koksunbaev-hash/electric_meters/diagnostics/README.md

# Диагностические скетчи ESP32

Эти скетчи помогли найти неисправности, которые снаружи выглядели одинаково — «данные не идут». Каждый проверяет одно звено.

| Скетч | Что проверяет | Норма |
|---|---|---|
| [`esp32-pin-check2`](esp32-pin-check2) | Исправность ножек ESP32: вывод удерживает заданный уровень, подтяжки работают. Запускать на плате без обвязки | `itogo neispravnyh vyvodov: 0` |
| [`esp32-meter-diag`](esp32-meter-diag) | Отвечает ли счётчик DDSD6868 по Modbus | `OTVET VERNYY, U=...` |
| [`esp32-ro-level`](esp32-ro-level) | Запитан ли MAX485 и жив ли его приёмник: уровень покоя на выходе RO | RO высокий, 200 из 200 |
| [`esp32-ab-drive`](esp32-ab-drive) | Жив ли передатчик MAX485: передатчик включён постоянно, вход DI медленно переключается. Мультиметр на A–B | Знак меняется, модуль 2–5 В |
| [`esp32-dtu-listen`](esp32-dtu-listen) | Выдаёт ли модем EWD95M текст при включении питания | `NVM DATA STORED`, `+EVT:JOINED` |

Все скетчи выводят результат в монитор порта на 115200.

## Как пользоваться

Иди от сервера к проводу и останавливайся на первом звене, где данных нет (см. [инструкцию](../docs/instruction.md#если-данные-перестали-приходить)). Когда дошёл до железа:

1. Плата ESP32 не отвечает вовсе — сними обвязку и попробуй `esptool --port COMx chip-id`. Не отвечает даже с зажатой BOOT — плата мертва.
2. Плата жива — `esp32-pin-check2` на голой плате.
3. Ножки целы — `esp32-ro-level`, затем `esp32-ab-drive` с мультиметром.
4. Всегда сравнивай с заведомо рабочим модулем: одно измерение без образца легко прочитать неверно.

## Одно правило

Не настраивай на передачу ножку, к которой подключён выход RO преобразователя. Два выхода на одном проводе упираются друг в друга, и порт зависает до перезагрузки. Порядок выводов RO и DI проверяется мультиметром, а не перебором в прошивке.
