koksunbaev-hash/electric_meters/docs/reports/Отчет Однофазный счетчик LoRaWAN.docx

________________________________________________

(наименование организации)

УТВЕРЖДАЮ

_____________________ /_______________/

(должность, подпись, расшифровка)

«____» ______________ 2026 г.

ОТЧЁТ

о вводе в действие системы удалённого учёта электроэнергии

на базе однофазного счётчика CHZSJ DDSD6868 с передачей данных

по сети LoRaWAN в платформу цифровых двойников OpenEgiz

Объект учёта: испытательный стенд лаборатории lower_lab

Идентификатор цифрового двойника: lower_lab:lorawan-meter

Сетевой сервер LoRaWAN: ChirpStack, 192.168.8.122

Сервер платформы: 192.168.0.199

Период выполнения работ: с 9 по 14 сентября 2026 г.

Исполнитель: _____________________ /_______________/

(должность, подпись, расшифровка)

Редакция 1.0

2026 г.

# Аннотация

Настоящий отчёт содержит результаты работ по вводу в действие системы удалённого учёта электроэнергии на базе однофазного счётчика CHZSJ DDSD6868. Система включает прибор учёта, узел сопряжения на базе микроконтроллера ESP32 с двумя интерфейсами RS485, оконечное устройство LoRaWAN Ebyte EWD95M, базовую станцию, сетевой сервер ChirpStack и серверную часть на платформе цифровых двойников OpenEgiz, развёрнутой на узле 192.168.0.199.

Отличительной особенностью системы является передача показаний по сети LoRaWAN вместо ранее применявшегося канала Wi-Fi. Такое решение обеспечивает связь на расстояниях до нескольких километров и не требует наличия точки доступа в месте установки прибора учёта.

В отчёте описаны состав и назначение полевого оборудования, протокол обмена с прибором учёта, формат передаваемого пакета, порядок его расшифровки на сетевом сервере, состав серверных программных компонентов и маршрут данных до средств отображения. Приведены результаты проверки работоспособности системы и рекомендации по её эксплуатации и развитию.

Отчёт предназначен для руководства и заказчика проекта, а также для специалистов, осуществляющих эксплуатацию и развитие системы. Разделы 1 и 2 не требуют специальной подготовки, технические сведения вынесены в приложения.

Отчёт содержит 8 разделов и два приложения, 15 таблиц.

# СОДЕРЖАНИЕ

Аннотация ..................................................................... 2

Термины, определения и сокращения ............................................. 4

1. Введение ................................................................... 6

2. Общее описание системы ..................................................... 8

3. Полевое оборудование узла учёта ............................................ 9

4. Передача и обработка данных ................................................ 12

5. Серверная часть ............................................................ 15

6. Результаты проверки работоспособности ...................................... 18

7. Рекомендации по эксплуатации и развитию .................................... 20

8. Заключение ................................................................. 21

Приложение А. Справочные параметры системы .................................... 22

Приложение Б. Состав разработанного программного обеспечения .................. 23

# Термины, определения и сокращения

В настоящем отчёте применяются следующие термины и сокращения.

Таблица 1. Термины и сокращения

Термин | Определение
LoRaWAN | Протокол беспроводной связи для устройств телеметрии, работающий в нелицензируемых частотных диапазонах. Обеспечивает дальность до нескольких километров при малом энергопотреблении.
EU868 | Частотный план LoRaWAN для диапазона 863–870 МГц. Предусматривает ограничение занятости эфира одним процентом времени.
OTAA | Способ подключения устройства к сети LoRaWAN по ключам шифрования с получением сеансовых параметров от сетевого сервера.
DevEUI | Уникальный заводской идентификатор оконечного устройства LoRaWAN, 8 байт.
AppKey | Ключ приложения, применяемый при подключении устройства к сети способом OTAA, 16 байт.
Класс A | Режим работы оконечного устройства, при котором приём возможен только в двух окнах после собственной передачи. Обеспечивает наименьшее энергопотребление.
Базовая станция | Приёмопередающее устройство сети LoRaWAN, принимающее пакеты от оконечных устройств и передающее их сетевому серверу.
ChirpStack | Сетевой сервер LoRaWAN с открытым исходным кодом. Выполняет подключение устройств, проверку целостности пакетов и их выдачу прикладным системам.
Декодер пакета | Программа на языке JavaScript, исполняемая сетевым сервером и преобразующая двоичный пакет в именованные величины.
RS485 | Промышленный последовательный интерфейс передачи данных по двухпроводной линии (цепи A и B). Применяется для подключения приборов учёта.
Modbus RTU | Протокол обмена данными по последовательной линии, применяемый в приборах учёта. Обмен ведётся кадрами с контрольной суммой CRC16.
UART | Последовательный порт микроконтроллера. Преобразователь RS485/UART согласует уровни сигналов прибора учёта и контроллера.
DE/RE | Вывод управления направлением передачи преобразователя RS485. Высокий уровень переводит преобразователь в режим передачи, низкий — в режим приёма.
ESP32 | Микроконтроллер с двумя вычислительными ядрами и встроенными модулями Wi-Fi и Bluetooth, применяемый в узле сопряжения.
MQTT | Протокол обмена сообщениями для устройств телеметрии по модели «издатель, брокер, подписчик».
Брокер MQTT | Серверная программа, принимающая сообщения от издателей и передающая их подписчикам. В системе применяется Mosquitto.
Мост данных | Служебная программа, переносящая сообщения между двумя брокерами MQTT с преобразованием формата.
JSON | Текстовый формат представления структурированных данных.
Цифровой двойник | Программное представление физического объекта, хранящее его текущее состояние.
Eclipse Ditto | Программная платформа управления цифровыми двойниками, ядро OpenEgiz.
OpenEgiz | Платформа цифровых двойников на базе OpenTwins, развёрнутая на сервере системы.
InfluxDB | База данных временных рядов для хранения измерений с метками времени.
Grafana | Средство визуализации данных и построения информационных панелей.
systemd | Подсистема управления службами Linux, обеспечивающая автоматический запуск и перезапуск программ.

# 1. Введение

## 1.1. Цель работ

Целью работ является ввод в действие системы удалённого учёта электроэнергии на базе однофазного счётчика CHZSJ DDSD6868 с передачей показаний по сети LoRaWAN, включая настройку полевого оборудования, разработку программного обеспечения узла сопряжения, организацию маршрута данных до платформы цифровых двойников и средств визуализации.

## 1.2. Объект работ

Объектом работ является измерительный комплекс, состоящий из однофазного электросчётчика, узла сопряжения на базе микроконтроллера ESP32, оконечного устройства LoRaWAN и серверной части. Комплекс обеспечивает автоматическое считывание показаний прибора учёта, их передачу по радиоканалу и последующее хранение, обработку и визуализацию.

## 1.3. Исходные данные

Работы выполнены на основании следующих исходных данных:

- однофазный электросчётчик CHZSJ DDSD6868, заводской номер 2511262172, с интерфейсом RS485;
- оконечное устройство LoRaWAN Ebyte EWD95M с интерфейсом RS485, заводской идентификатор 0080E115053FE291;
- микроконтроллер ESP32-D0WD-V3, адрес 1c:c3:ab:b4:94:30, и два преобразователя RS485/UART на микросхеме MAX485;
- действующая базовая станция LoRaWAN с идентификатором 0016c001f17a6c24 и сетевой сервер ChirpStack на узле 192.168.8.122;
- действующая платформа OpenEgiz на узле 192.168.0.199 с ранее настроенным контуром приёма сообщений;
- руководство по эксплуатации серии EWD95M (редакция 1.2) и техническая документация прибора учёта.

## 1.4. Методика выполнения работ

Работы выполнялись в следующем порядке.

1. Определение протокола обмена и карты регистров прибора учёта опытным путём с последующей сверкой полученных значений с показаниями встроенного дисплея.
2. Сборка полевого узла: подключение прибора учёта и оконечного устройства LoRaWAN к микроконтроллеру через раздельные преобразователи RS485.
3. Разработка и отладка программы микроконтроллера, обеспечивающей опрос прибора учёта, формирование пакета и управление оконечным устройством командами AT.
4. Регистрация оконечного устройства на сетевом сервере, проверка подключения к сети и прохождения пакетов.
5. Разработка декодера пакета для сетевого сервера и его проверка на фактически принятых пакетах.
6. Разработка моста данных между сетевым сервером и платформой цифровых двойников, его установка на сервер в виде службы с автоматическим запуском.
7. Создание информационной панели в средстве визуализации и сквозная проверка маршрута данных от прибора учёта до графика.

# 2. Общее описание системы

Система обеспечивает автоматическое считывание показаний однофазного электросчётчика с периодом 30 секунд и передачу их на сервер платформы OpenEgiz по радиоканалу LoRaWAN. Применение LoRaWAN отличает настоящую систему от ранее введённых узлов учёта, использующих Wi-Fi, и позволяет размещать прибор учёта вне зоны действия точки доступа.

Маршрут данных состоит из двух участков. На первом участке микроконтроллер опрашивает прибор учёта по проводной линии RS485 и передаёт результат оконечному устройству LoRaWAN, также по линии RS485. На втором участке оконечное устройство передаёт пакет по радиоканалу базовой станции, которая направляет его сетевому серверу ChirpStack. Сетевой сервер расшифровывает пакет и публикует результат в своём брокере сообщений.

Мост данных, работающий на сервере платформы, переносит расшифрованные показания в брокер OpenEgiz. Далее данные обрабатываются двумя независимыми контурами, ранее созданными для других узлов учёта.

- Контур архива измерений. Каждое измерение сохраняется в базе данных временных рядов с меткой времени и обеспечивает ретроспективный анализ за произвольный период.
- Контур цифрового двойника. Последние значения измеряемых величин записываются в цифровой двойник объекта и обеспечивают оперативный контроль текущего состояния.

Таблица 2. Основные характеристики системы

Показатель | Значение
Объект учёта | Испытательный стенд лаборатории lower_lab
Прибор учёта | Однофазный электросчётчик CHZSJ DDSD6868, заводской номер 2511262172
Измеряемые величины | 5 параметров: напряжение, ток, активная мощность, коэффициент мощности, активная энергия
Протокол обмена с прибором учёта | Modbus RTU, 9600 бит/с, 8 бит данных, чётность even, 1 стоповый бит
Период опроса | 30 секунд (2 880 измерений в сутки)
Канал передачи | LoRaWAN, частотный план EU868, класс устройства A
Размер передаваемого пакета | 12 байт, прикладной порт 2
Сетевой сервер LoRaWAN | ChirpStack, 192.168.8.122
Платформа цифровых двойников | OpenEgiz, 192.168.0.199
Идентификатор цифрового двойника | lower_lab:lorawan-meter
Начало накопления данных | 09.09.2026
Уровень принимаемого сигнала | от минус 99 до минус 110 дБм, отношение сигнал/шум от 5 до 10 дБ

# 3. Полевое оборудование узла учёта

## 3.1. Состав оборудования

Состав полевого оборудования приведён в таблице 3. Узел сопряжения содержит два независимых преобразователя RS485: первый обслуживает линию связи с прибором учёта, второй — линию связи с оконечным устройством LoRaWAN. Раздельные линии применены в связи с различием форматов кадра: прибор учёта работает с контролем чётности, оконечное устройство — без него.

Таблица 3. Состав полевого оборудования

Оборудование | Назначение | Характеристики
Электросчётчик CHZSJ DDSD6868 | Измерение параметров однофазной сети и учёт активной энергии | 220 В, 5(60) А, 50 Гц, 1600 имп/кВт·ч, стандарт GB/T 17215.321-2021, интерфейс RS485 (клеммы 6 и 5), импульсный выход (клеммы 1 и 2), заводской номер 2511262172
Преобразователь RS485/UART № 1 | Согласование интерфейса прибора учёта с портом контроллера | Плата на микросхеме MAX485, управление направлением передачи выводом DE/RE
Преобразователь RS485/UART № 2 | Согласование интерфейса оконечного устройства с портом контроллера | Плата на микросхеме MAX485, управление направлением передачи выводом DE/RE
Микроконтроллер ESP32 | Опрос прибора учёта, формирование пакета, управление оконечным устройством | ESP32-D0WD-V3, ревизия 3.1, два ядра, 240 МГц, флеш-память 4 МБ, адрес 1c:c3:ab:b4:94:30
Оконечное устройство LoRaWAN Ebyte EWD95M | Передача пакета по радиоканалу | Диапазон 863–870 МГц, класс A, интерфейс RS485 9600 бит/с 8N1, питание от 5 до 28 В постоянного тока, монтаж на DIN-рейку
Базовая станция LoRaWAN | Приём пакетов и передача их сетевому серверу | Идентификатор 0016c001f17a6c24, частотный план EU868
Блок питания 220/5 В | Питание контроллера и преобразователей | Импульсный, выходное напряжение 5 В

## 3.2. Измеряемые величины

Из прибора учёта считываются пять величин. Соответствие адресов регистров, масштабных множителей и имён признаков цифрового двойника приведено в таблице 4. Карта регистров определена опытным путём с последующей сверкой полученных значений с показаниями встроенного дисплея прибора учёта.

Таблица 4. Измеряемые величины и карта регистров

Величина | Регистр | Формат | Множитель | Признак двойника
Напряжение, В | 0x0000 | uint16 | 0,1 | voltage_a_v
Ток, А | 0x0003 | uint16 | 0,01 | current_a_a
Активная мощность, Вт | 0x0008 | uint16 | 1 | active_power_w
Коэффициент мощности | 0x0013 | uint16 | 0,001 | power_factor_total
Активная энергия, кВт·ч | 0x001D–0x001E | uint32 | 0,01 | active_energy_positive_kwh

Частота сети (регистр 0x001A, множитель 0,01) считывается и выводится в служебный журнал контроллера, но в передаваемый пакет не включена в целях сокращения его размера.

## 3.3. Порядок работы контроллера

Программа контроллера esp32-meter-lorawan-v7 выполняет следующие действия.

8. Инициализация портов: порт прибора учёта настраивается на 9600 бит/с с контролем чётности, порт оконечного устройства — на 9600 бит/с без контроля чётности.
9. Поиск оконечного устройства LoRaWAN. Программа последовательно опрашивает четыре предусмотренных набора выводов командой AT и закрепляет за собой тот, на котором получен ответ. Решение позволяет изменять монтаж без перепрошивки контроллера.
10. Считывание заводского идентификатора и частотного плана оконечного устройства. Частотный план принимается таким, как он задан в устройстве, и программой не изменяется.
11. Подключение к сети LoRaWAN способом OTAA командой AT+CJOIN. Устройство настроено на автоматическое подключение при включении питания.
12. Опрос прибора учёта: передача кадра Modbus, приём ответа, проверка контрольной суммы CRC16, масштабирование значений. При отсутствии ответа выполняется до трёх повторных попыток.
13. Формирование пакета размером 12 байт и передача его оконечному устройству командой AT+SEND с указанием прикладного порта 2.
14. Ожидание следующего цикла. Период передачи составляет 30 секунд.

Управление направлением передачи преобразователей RS485 выполняется программно выводом DE/RE. Линия удерживается в режиме передачи на время отправки кадра и освобождается непосредственно после его окончания, что необходимо для приёма ответа.

Таблица 5. Назначение выводов микроконтроллера

Линия | Приём (RO) | Передача (DI) | Управление (DE/RE) | Формат кадра
Прибор учёта | GPIO 26 | GPIO 27 | GPIO 5 | 9600, 8E1
Оконечное устройство LoRaWAN | GPIO 19 | GPIO 18 | GPIO 23 | 9600, 8N1

Примечание. Программа контроллера предусматривает передачу пакета только после успешного считывания показаний. Нарушение линии RS485 или питания прибора учёта приводит к прекращению передачи при сохранении работоспособности радиоканала.

# 4. Передача и обработка данных

## 4.1. Маршрут данных

Маршрут данных от прибора учёта до средств отображения приведён в таблице 6. Маршрут включает семь участков и два сервера.

Таблица 6. Маршрут передачи и обработки данных

№ | Участок | Среда передачи | Формат данных
1 | Прибор учёта — узел сопряжения | RS485, двухпроводная линия | Кадр Modbus RTU
2 | Узел сопряжения — оконечное устройство | RS485, двухпроводная линия | Команда AT+SEND с пакетом в шестнадцатеричном виде
3 | Оконечное устройство — базовая станция | Радиоканал LoRaWAN, EU868 | Пакет 12 байт, прикладной порт 2
4 | Базовая станция — сетевой сервер | Локальная сеть | Протокол базовой станции
5 | Сетевой сервер — мост данных | Брокер MQTT сервера ChirpStack | Сообщение JSON с полем object
6 | Мост данных — платформа OpenEgiz | Брокер MQTT 192.168.0.199:30511 | Сообщение JSON с полями device_id и data
7 | Платформа — средства отображения | Внутренние подписки платформы | Признаки цифрового двойника и записи архива

## 4.2. Формат передаваемого пакета

Пакет имеет постоянный размер 12 байт. Такой размер выбран из условия сокращения занятости эфира: при частотном плане EU868 действует ограничение на долю времени передачи, равное одному проценту. Структура пакета приведена в таблице 7.

Таблица 7. Структура передаваемого пакета

Байты | Содержание | Формат | Множитель
0 | Версия формата, значение 0x01 | uint8 | —
1–2 | Напряжение, В | uint16, старший байт первым | 0,1
3–4 | Ток, А | uint16, старший байт первым | 0,01
5–6 | Активная мощность, Вт | uint16, старший байт первым | 1
7 | Коэффициент мощности | uint8 | 0,01
8–11 | Активная энергия, кВт·ч | uint32, старший байт первым | 0,01

Пример фактически принятого пакета и результат его расшифровки:

01 08 75 00 00 00 00 64 00 00 00 36

напряжение 216,5 В

ток 0,00 А

активная мощность 0 Вт

коэффициент мощности 1,00

активная энергия 0,54 кВт·ч

## 4.3. Расшифровка пакета на сетевом сервере

Расшифровка выполняется программой на языке JavaScript, размещённой в профиле устройства EWD95M на сетевом сервере ChirpStack. Программа проверяет размер пакета и версию формата, после чего выделяет пять величин и возвращает их именованными полями. При несоответствии размера или версии возвращается сообщение об ошибке, что исключает запись недостоверных значений.

Имена возвращаемых полей выбраны совпадающими с именами признаков цифрового двойника, что позволяет переносить значения без дополнительного преобразования.

## 4.4. Мост данных

Сетевой сервер ChirpStack и платформа OpenEgiz размещены в различных подсетях и непосредственного обмена не ведут. Перенос сообщений выполняет мост данных — программа chirpstack_to_opentwins.py, установленная на сервере платформы.

Мост подписан на группу топиков сетевого сервера, соответствующую пакетам от оконечных устройств, и выполняет следующие действия: определяет заводской идентификатор устройства, сопоставляет его с идентификатором цифрового двойника по таблице соответствия, извлекает расшифрованные величины и публикует их в брокер платформы.

Предусмотрено резервное поведение: если расшифрованные величины в сообщении отсутствуют, мост самостоятельно разбирает двоичный пакет по тем же правилам, что и декодер сетевого сервера. Это обеспечивает работоспособность системы при изменении настроек сетевого сервера.

Мост восстанавливает соединение с любым из двух брокеров при его потере и ведёт журнал работы средствами операционной системы.

## 4.5. Формат сообщения платформы

Сообщение, публикуемое мостом, представляет собой текст в формате JSON. Поле device_id содержит идентификатор цифрового двойника, объект data содержит измеренные величины.

{ "device_id": "lower_lab:lorawan-meter",

"data": { "voltage_a_v": 216.6,

"current_a_a": 0.0,

"active_power_w": 0,

"power_factor_total": 1.0,

"active_energy_positive_kwh": 0.54 } }

Сообщение публикуется в топик opentwins/lower_lab:lorawan-meter. Серверные компоненты платформы подписаны на группу топиков opentwins/#, что позволило подключить новый прибор учёта без изменения их конфигурации.

# 5. Серверная часть

## 5.1. Сетевой сервер LoRaWAN

Сетевой сервер ChirpStack размещён на узле 192.168.8.122. Параметры регистрации оконечного устройства приведены в таблице 8.

Таблица 8. Параметры устройства на сетевом сервере

Параметр | Значение
Веб-интерфейс | http://192.168.8.122:8080
Брокер сообщений | 192.168.8.122:1883
Базовая станция | 0016c001f17a6c24, состояние: на связи
Профиль устройства | EWD95M, частотный план EU868, класс A, способ подключения OTAA
Заводской идентификатор (DevEUI) | 0080E115053FE291
Идентификатор приложения (JoinEUI) | 0000000000000000
Адрес в сети (DevAddr) | назначается сетевым сервером при подключении
Прикладной порт | 2
Декодер пакета | JavaScript, размещён в профиле устройства

## 5.2. Платформа цифровых двойников

Платформа OpenEgiz размещена на узле 192.168.0.199 в кластере Kubernetes. Компоненты, задействованные в настоящей системе, приведены в таблице 9. Состав компонентов платформы при выполнении работ не изменялся.

Таблица 9. Задействованные программные компоненты платформы

Компонент | Назначение | Порт
Mosquitto | Брокер MQTT, приём сообщений от моста данных | 30511
Eclipse Ditto | Управление цифровыми двойниками, преобразование сообщений | 30525
InfluxDB 2 | База данных временных рядов, архив измерений | 30716
Grafana | Визуализация данных, информационные панели | 30718
MongoDB | Хранение состояния цифровых двойников | 30717
opentwins-bridge | Мост данных, служба systemd, установлена в ходе настоящих работ | —

## 5.3. Цифровой двойник объекта учёта

Для объекта учёта зарегистрирован цифровой двойник со следующими параметрами.

Таблица 10. Параметры цифрового двойника

Параметр | Значение
Идентификатор | lower_lab:lorawan-meter
Наименование | LoRaWAN meter DDSD6868
Описание | EWD95M → ChirpStack → OpenEgiz
Политика доступа | lower_lab:lorawan-meter
Число признаков | 5
Источник данных | Электросчётчик CHZSJ DDSD6868 через сеть LoRaWAN

## 5.4. Служба моста данных

Мост данных установлен на сервере платформы в виде службы systemd с именем opentwins-bridge. Служба запускается автоматически при загрузке операционной системы и перезапускается при любом аварийном завершении с задержкой 10 секунд. Журнал работы ведётся средствами journald.

Размещение моста на сервере платформы исключает зависимость системы от персонального компьютера оператора и обеспечивает круглосуточную передачу данных.

## 5.5. Информационная панель

В средстве визуализации создана информационная панель с идентификатором ddsd6868-lorawan. Панель содержит пять полей текущих значений и четыре графика: напряжение, активная мощность, ток и накопленная энергия. Период обновления составляет 30 секунд, отображаемый интервал по умолчанию — 6 часов. Адрес панели: http://192.168.0.199:30718/d/ddsd6868-lorawan

# 6. Результаты проверки работоспособности

## 6.1. Сквозная проверка маршрута

Выполнена сквозная проверка маршрута данных на всех семи участках. Результаты приведены в таблице 11.

Таблица 11. Результаты проверки участков маршрута

Участок | Способ проверки | Результат
Прибор учёта — узел сопряжения | Служебный журнал контроллера, сверка с дисплеем прибора учёта | Показания считываются, значения совпадают
Узел сопряжения — оконечное устройство | Ответ устройства на команды AT в служебном журнале | Устройство отвечает на команды
Оконечное устройство — сеть LoRaWAN | Событие подключения на сетевом сервере | Подключение выполнено, адрес в сети назначен
Радиоканал | Уровень сигнала и отношение сигнал/шум принятых пакетов | От минус 99 до минус 110 дБм, от 5 до 10 дБ
Сетевой сервер — расшифровка | Сравнение расшифрованных величин с показаниями контроллера | Значения совпадают
Мост данных | Журнал службы, состояние цифрового двойника | Сообщения переносятся, двойник обновляется
Архив и визуализация | Запрос к базе данных временных рядов | Записи поступают, метки времени соответствуют моменту передачи

## 6.2. Накопленные данные

Первые записи в архиве измерений датированы 9 сентября 2026 г. Сведения о накопленных данных приведены в таблице 12.

Таблица 12. Сведения о накопленных данных

Показатель | Значение
Первая запись | 09.09.2026
Последняя запись на дату отчёта | 14.09.2026
Измерение в базе данных | esp_telemetry, тег thingId
Диапазон напряжения | от 215,4 до 219,3 В
Показание активной энергии | изменилось с 0,23 до 0,54 кВт·ч
Наибольшая зафиксированная мощность | 100 Вт (испытательная нагрузка)
Период передачи | 30 секунд

## 6.3. Оценка работоспособности

Измерительная цепь, радиоканал и серверная часть функционируют в соответствии с заложенным алгоритмом. Значения физически правдоподобны и согласуются с показаниями встроенного дисплея прибора учёта. Архив измерений ведётся, цифровой двойник обновляется, информационная панель отображает текущие значения и графики.

При испытаниях под нагрузкой мощностью 100 Вт зафиксировано соответствующее изменение тока, коэффициента мощности и приращение показаний активной энергии, что подтверждает достоверность передаваемых величин.

Уровень принимаемого сигнала при расположении оконечного устройства и базовой станции в пределах одного здания составляет от минус 99 до минус 110 дБм при отношении сигнал/шум от 5 до 10 дБ, что обеспечивает устойчивый приём с запасом.

# 7. Рекомендации по эксплуатации и развитию

Таблица 13. Рекомендации

№ | Содержание | Обоснование
1 | Увеличить период передачи с 30 секунд до 5 минут | Частотный план EU868 предусматривает ограничение занятости эфира одним процентом времени. Период 5 минут обеспечивает запас по этому ограничению. Изменение выполняется одной строкой в программе контроллера.
2 | Установить согласующий резистор 120 Ом между цепями A и B на дальнем конце каждой линии RS485 | Мера предусмотрена руководством по эксплуатации оконечного устройства и повышает устойчивость связи, в особенности при увеличении длины линии.
3 | Выполнять переключение цепей A и B только при снятом питании | Переключение под напряжением является основной причиной выхода из строя микросхем интерфейса RS485.
4 | Перевести соединения узла сопряжения на клеммные колодки и закрепить платы на DIN-рейке | Навесной монтаж подвержен нарушению контакта, что приводит к прекращению передачи данных.
5 | Настроить оповещение при отсутствии данных более 15 минут | Обеспечивает своевременное обнаружение прекращения передачи. Настраивается средствами Grafana.
6 | Заменить заводские учётные данные веб-интерфейсов Grafana, ChirpStack и InfluxDB | Заводские учётные данные допускают несанкционированное изменение настроек и удаление данных из локальной сети.
7 | Организовать резервное копирование конфигурации сетевого сервера и профиля устройства | Восстановление ключей подключения и декодера пакета при отказе оборудования потребует значительного времени.
8 | При подключении дополнительных приборов учёта расширить таблицу соответствия в мосте данных | Мост рассчитан на обслуживание нескольких устройств, для добавления достаточно указать заводской идентификатор и идентификатор цифрового двойника.

# 8. Заключение

По результатам выполненных работ система удалённого учёта электроэнергии на базе однофазного счётчика CHZSJ DDSD6868 смонтирована, настроена и введена в действие. Показания прибора учёта считываются узлом сопряжения на базе ESP32 по интерфейсу RS485 с периодом 30 секунд, передаются по сети LoRaWAN на базовую станцию и далее через сетевой сервер ChirpStack и мост данных поступают в платформу цифровых двойников OpenEgiz, где сохраняются в архиве измерений и отражаются в цифровом двойнике объекта.

Сквозная проверка маршрута выполнена на всех семи участках и подтвердила работоспособность системы. Достоверность передаваемых величин подтверждена сверкой с показаниями встроенного дисплея прибора учёта и испытаниями под нагрузкой.

Мост данных установлен на сервере платформы в виде службы с автоматическим запуском, что обеспечивает круглосуточную работу системы без участия оператора. Создана информационная панель для оперативного контроля и ретроспективного анализа.

Настоящая система является первым узлом учёта в лаборатории, использующим передачу данных по сети LoRaWAN. Применённые решения — формат пакета, декодер и мост данных — рассчитаны на подключение дополнительных приборов учёта без изменения серверной части.

Для повышения надёжности рекомендуется в первую очередь выполнить мероприятия 1, 4 и 5 таблицы 13: увеличить период передачи, закрепить соединения узла сопряжения и организовать оповещение о прекращении поступления данных. Мероприятия 6 и 7 относятся к эксплуатационной безопасности и подлежат выполнению до расширения системы.

# Приложение А. Справочные параметры системы

Таблица 14. Справочные параметры

Параметр | Значение
Прибор учёта | CHZSJ DDSD6868, заводской номер 2511262172, Modbus RTU, адрес 1, 9600 бит/с 8E1
Регистры прибора учёта | 0x0000 напряжение ×0,1; 0x0003 ток ×0,01; 0x0008 мощность; 0x0013 коэффициент мощности ×0,001; 0x001D–0x001E энергия ×0,01
Контроллер | ESP32-D0WD-V3, адрес 1c:c3:ab:b4:94:30, программа esp32-meter-lorawan-v7
Линия прибора учёта | RO 26, DI 27, DE/RE 5; 9600 бит/с 8E1
Линия оконечного устройства | RO 19, DI 18, DE/RE 23; 9600 бит/с 8N1
Оконечное устройство | Ebyte EWD95M, DevEUI 0080E115053FE291, EU868, класс A, OTAA, питание от 5 до 28 В
Базовая станция | 0016c001f17a6c24
Сетевой сервер | ChirpStack, 192.168.8.122, веб-интерфейс порт 8080, брокер порт 1883
Пакет | 12 байт, прикладной порт 2, версия формата 0x01
Мост данных | chirpstack_to_opentwins.py, каталог /opt/opentwins-bridge, служба systemd opentwins-bridge
Брокер платформы | 192.168.0.199:30511, топик opentwins/lower_lab:lorawan-meter, подписка платформы opentwins/#
Формат сообщения платформы | {"device_id": "<ns>:<name>", "data": {<поле>: <число>, ...}}
Цифровой двойник | lower_lab:lorawan-meter, политика доступа lower_lab:lorawan-meter
Преобразование в двойник | Соединение Ditto mosquitto-source-connection, правило esp-mapping: каждое поле data записывается как признак с properties.value
Архив измерений | InfluxDB 2, bucket default, измерение esp_telemetry, тег thingId
Информационная панель | Grafana, http://192.168.0.199:30718/d/ddsd6868-lorawan

# Приложение Б. Состав разработанного программного обеспечения

В ходе работ разработаны и переданы заказчику следующие программные компоненты.

Таблица 15. Разработанное программное обеспечение

Наименование | Назначение | Размещение
esp32-meter-lorawan-v7.ino | Программа микроконтроллера: опрос прибора учёта, поиск оконечного устройства, формирование и передача пакета | Каталог проектов Arduino, загружена во флеш-память контроллера
chirpstack_decoder_ddsd6868.js | Декодер пакета для сетевого сервера ChirpStack | Профиль устройства EWD95M, раздел Codec
chirpstack_to_opentwins.py | Мост данных между сетевым сервером и платформой цифровых двойников | /opt/opentwins-bridge на сервере 192.168.0.199
opentwins-bridge.service | Описание службы автоматического запуска моста данных | /etc/systemd/system на сервере 192.168.0.199
Информационная панель ddsd6868-lorawan | Отображение текущих значений и графиков | Grafana, сервер 192.168.0.199

Порядок обслуживания моста данных приведён ниже.

sudo systemctl status opentwins-bridge состояние службы

sudo systemctl restart opentwins-bridge перезапуск службы

journalctl -u opentwins-bridge -f просмотр журнала

Отчёт о вводе в действие узла учёта электроэнергии. Лист
