koksunbaev-hash/electric_meters/docs/guides/Монтаж_счетчика_DDSD6868.html

# Монтаж счётчика DDSD6868

Стационарная установка однофазного счётчика CHZSJ DDSD6868 с передачей показаний по LoRaWAN через ESP32 и модем Ebyte EWD95M.

Работа под напряжением сети Силовая часть монтажа выполняется при снятом напряжении. Отключи вводной автомат, проверь отсутствие напряжения индикаторной отвёрткой или мультиметром на всех жилах, и только потом работай. Если у тебя нет допуска к электромонтажным работам, силовую часть должен выполнить электрик. Слаботочную часть, кабель RS485 и электронику, можно монтировать самостоятельно.

## Что понадобится

Позиция | Что именно | Зачем
DIN-рейка | 35 мм, отрезок по месту | Крепление счётчика
Автомат защиты | Однополюсный, по току нагрузки, но не более 60 А | Перед счётчиком, по схеме
Силовой провод | ПуГВ или ВВГнг, сечение по току нагрузки | Ввод и выход счётчика
Кабель RS485 | Экранированная витая пара, например КСПВГ 2×0.5 или одна пара из FTP Cat5e | Линия данных до электроники
Наконечники НШВИ | По сечению провода | Обжим жил в клеммы
Резистор 120 Ом | 0.25 Вт | Согласование линии, если длиннее 20 метров
Блоки питания | 5 В не менее 1 А и 12 В не менее 0.5 А | ESP32 и модем EWD95M
Корпус или шкаф | Пластиковый, с DIN-рейкой | Электроника и модем

Про кабель, это важнее всего Провода A и B обязаны быть витой парой, скрученной между собой. Именно скрутка даёт помехоустойчивость, на которой держится RS485. Два отдельных провода, проложенные рядом, работать будут, но нестабильно, и это станет источником загадочных сбоев. Экран нужен, если кабель идёт рядом с силовыми линиями.

## ШАГ 1Установка счётчика

Счётчик занимает четыре модуля на DIN-рейке. Ставь его в шкаф учёта или распределительный щит, защёлкнув на рейку до щелчка.

Место выбирай так, чтобы дисплей оставался читаемым, а до клемм можно было дотянуться отвёрткой. Над счётчиком и под ним оставь по несколько сантиметров для ввода проводов.

## ШАГ 2Силовое подключение

Нижние четыре винтовые клеммы, слева направо.

1фаза, ввод

2фаза, к нагрузке

3ноль, ввод

4ноль, к нагрузке

То есть счётчик включается в разрыв линии: питание входит в клеммы 1 и 3, а к нагрузке уходит из клемм 2 и 4.

1. Отключи вводной автомат и убедись, что напряжения нет.
2. Фазу от автомата обожми наконечником и заведи в клемму 1.
3. Из клеммы 2 веди фазу к нагрузке.
4. Ноль от шины заведи в клемму 3, а из клеммы 4 веди к нагрузке.
5. Заземление к счётчику не подключается, оно идёт к нагрузке напрямую.
6. Затяни винты как следует и подёргай каждый провод. Открытой меди снаружи клемм быть не должно.
7. Закрой прозрачную клеммную крышку.

Частая ошибка Перепутать ввод и выход, то есть подать питание в клеммы 2 и 4. Счётчик при этом включится и будет показывать напряжение, но считать станет неверно. Проверь дважды до подачи напряжения.

## ШАГ 3Кабель RS485 от счётчика

Верхний правый зелёный разъём счётчика, две клеммы.

6сигнал A

5сигнал B

Одну жилу витой пары заведи в клемму 6, вторую в клемму 5. Запомни или подпиши, какого цвета какая: на дальнем конце их нельзя перепутать, иначе связи не будет.

### Прокладка

- Держи кабель не ближе 30 сантиметров от силовых линий. Если пересечение неизбежно, пересекай под прямым углом.
- Не прокладывай в одном лотке или гофре с силовыми проводами.
- Длина при скорости 9600 бод спокойно допускает сотни метров, предел стандарта 1200 метров. Наш случай далеко внутри нормы.
- Экран кабеля заземляй только с одной стороны, со стороны электроники. Заземление с обоих концов создаёт петлю и наводки.
- Оставь по полметра запаса с каждой стороны на случай переделки.

### Согласующий резистор

Если длина кабеля больше двадцати метров, поставь резистор 120 Ом между жилами A и B на дальнем конце линии, то есть у электроники. Это гасит отражения сигнала. На коротких линиях он не нужен и даже мешает.

## ШАГ 4Шкаф с электроникой

В шкафу размещаются плата ESP32, два модуля MAX485 и модем EWD95M. Ставь его так, чтобы антенна модема смотрела в сторону шлюза и не была закрыта металлом.

### Подключение кабеля от счётчика

Жила от счётчика | Куда
Из клеммы 6 счётчика | Клемма A первого модуля MAX485
Из клеммы 5 счётчика | Клемма B первого модуля MAX485

### Первый модуль MAX485, линия счётчика

Вывод модуля | ESP32
RO | GPIO 26
DI | GPIO 27
DE и RE, замкнуты перемычкой | GPIO 5
VCC | 5V
GND | GND

### Второй модуль MAX485, линия модема

Вывод модуля | Куда
RO | ESP32, GPIO 19
DI | ESP32, GPIO 18
DE и RE, замкнуты перемычкой | ESP32, GPIO 22
VCC | ESP32, 5V
GND | ESP32, GND
Клемма A | EWD95M, клемма A
Клемма B | EWD95M, клемма B

Выводы 23 и 25 не использовать На этой плате ESP32 они вышли из строя и не выдают высокий уровень. В прошивке они исключены. Если понадобится перенести сигнал DE, запасные выводы — 21 и 13, прошивка проверяет их автоматически.

## ШАГ 5Питание

Устройство | Напряжение | Ток | Куда подключается
ESP32 | 5 В | от 1 А | Разъём USB платы
Оба модуля MAX485 | 5 В | — | С выводов 5V и GND платы ESP32
EWD95M | от 5 до 28 В, рекомендую 12 В | от 0.5 А | Клеммы плюс и минус модема

Общая земля Соедини минус питания модема EWD95M с выводом GND платы ESP32 одним проводом. Без общего нуля два устройства с разными источниками питания дают сбои связи по RS485, которые потом очень трудно искать.

Кабель питания ESP32 бери обычный, с линиями данных. Чисто зарядные кабели дают просадку напряжения, и плата начинает перезагружаться.

## ШАГ 6Антенна модема

- Прикрути антенну до упора рукой, без ключа.
- Располагай вертикально, по возможности выше.
- Металлический шкаф экранирует сигнал. Выноси антенну наружу через гермоввод или ставь шкаф пластиковый.
- Не прижимай антенну к металлу и не сворачивай кабель в кольцо.

## ШАГ 7Пуск и проверка

1. Проверь ещё раз силовые соединения при снятом напряжении.
2. Подай питание на электронику: сначала 5 В на ESP32, затем 12 В на модем.
3. Включи вводной автомат. Дисплей счётчика должен ожить и показать напряжение около 220 вольт.
4. Подожди минуту. Модем присоединится к сети сам.
5. Открой ChirpStack и убедись, что от устройства идут пакеты.
6. Открой дашборд Grafana и проверь, что значения обновляются.

### Если данных нет

- Дисплей счётчика горит и показывает напряжение.
- На модеме EWD95M горит индикатор питания.
- Индикатор обмена T/R на модеме мигает при передаче.
- Напряжение на выводах VCC и GND каждого модуля MAX485 около 5 вольт.
- Жилы A и B не перепутаны местами на дальнем конце кабеля.
- Минус питания модема соединён с GND платы ESP32.

Для точной диагностики подключи ESP32 к ноутбуку по USB и открой монитор порта на скорости 115200. Прошивка печатает, нашла ли она модем, читается ли счётчик и уходят ли пакеты.

## Справочные данные

Параметр | Значение
Счётчик | CHZSJ DDSD6868, однофазный, 5(60) А, 220 В
Протокол счётчика | Modbus RTU, адрес 1, 9600 8E1
Константа импульсного выхода | 1600 имп. на кВт·ч, клеммы 1 и 2 сверху
Модем | Ebyte EWD95M, исполнение LoRaWAN, 9600 8N1
Заводской номер модема | 0080E115053FE291
Частотный план | EU868, класс A, адаптивная скорость включена
Период передачи | 40 секунд
Прошивка | esp32-meter-lorawan-v7
Twin в OpenTwins | lower_lab:lorawan-meter
