koksunbaev-hash/electric_meters/wifi-oven/firmware/esp32_mqtt_li_reader/secrets.example.h

// Скопируйте этот файл в secrets.h и впишите свои значения.
// secrets.h внесён в .gitignore и в репозиторий не попадает.
#pragma once
#define WIFI_SSID      "имя_сети_wifi"
#define WIFI_PASSWORD  "пароль_wifi"
#define MQTT_USER      ""   // брокер OpenEgiz работает без авторизации
#define MQTT_PASSWORD  ""
